FrizzyElectronics/OLEDModule/README.md

# OLEDModule
LED display with a SSD1306 I2C LCD. This module integrates perfectly with the I2C connector on our [Grape Board](https://github.com/FrizzyElectronics/Grape). The board is designed for 0.96" OLED screen as seen on [here](https://www.buydisplay.com/download/manual/ER-OLED0.96_Series_Datasheet.pdf)
