FrizzyElectronics/OLEDModule/images/Design/Outline.dxf

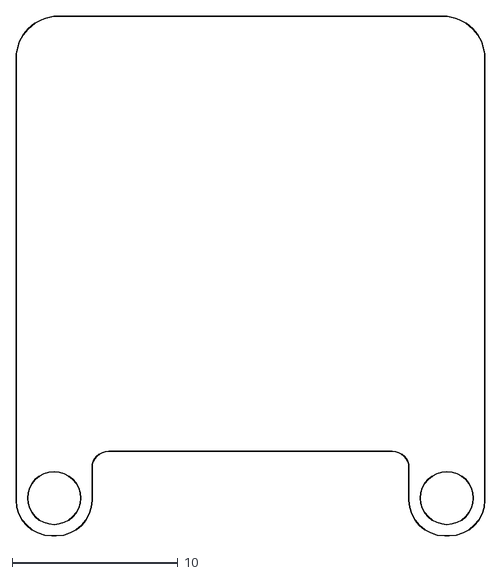
[picture p1: CAD file, 2017-05-22]
images/Design/Outline.dxf
28.3 x 31.4
