FrizzyElectronics/OLEDModule/pdf/OLEDModule.pdf

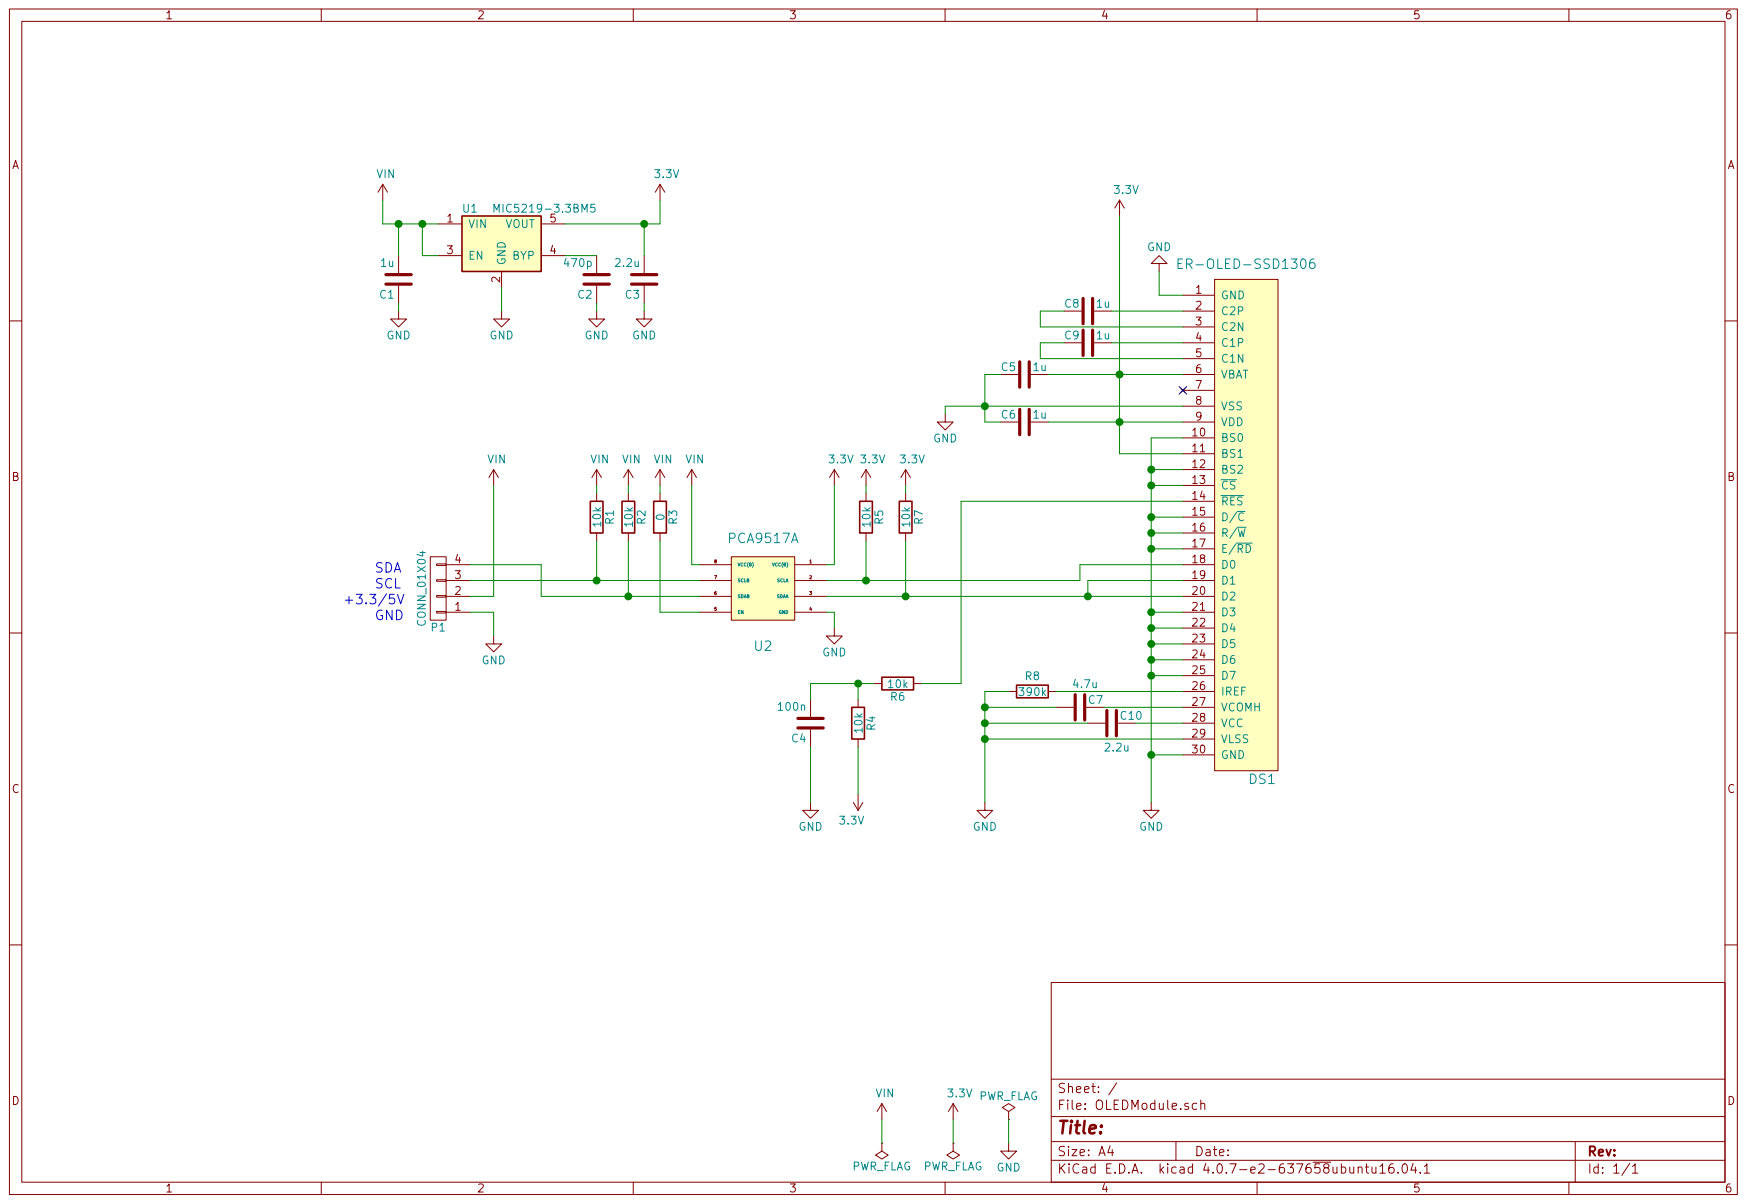
[picture p2: page 1]
