FrizzyElectronics/OLEDModule/(commit log)

2017-05-14 Esquema terminado
    [OLEDModule.kicad_pcb, OLEDModule.sch]
2017-05-15 empezando el layout
    [OLEDModule.kicad_pcb]
2017-05-15 Conector cambiado a SMD
    [OLEDModule.kicad_pcb, OLEDModule.sch]
2017-05-22 Placa enrutada
    [OLEDModule.kicad_pcb, _saved_OLEDModule.sch]
2017-05-22 Board outline
    [Outline.dxf]
2017-05-22 Placa enrutada y trabajando en el outline
    [OLEDModule.kicad_pcb, OLEDModule.sch, _saved_OLEDModule.sch]
2017-05-22 Working on the outline
    [Outline.dxf]
2017-05-22 Outline uploaded
    [Outline.dxf]
2017-05-22 Outline terminado
    [OLEDModule.kicad_pcb]
2017-05-22 Diseño terminado v1.0
    [OLEDModule.kicad_pcb]
2017-05-22 Diseño mandado a fabrica
    [OLEDModule.kicad_pcb]
2017-06-12 Pista haciendo corto arreglada
    [OLEDModule.kicad_pcb]
2018-01-20 Gerbers exportados
    Gerbers exportados para prueba de panelizacion
    [OLEDModule-B.Cu.gbl, OLEDModule-B.Mask.gbs, OLEDModule-B.SilkS.gbo, OLEDModule-Edge.Cuts.gko, OLEDModule-F.Cu.gtl, OLEDModule-F.Mask.gts, OLEDModule-F.SilkS.gto, OLEDModule.drl]
2018-02-05 logo nuevo cambiado
    [OLEDModule.kicad_pcb]
2018-03-04 arbol de carpetas cambiado
    [OLEDModule-B.Cu.gbl, OLEDModule-B.Mask.gbs, OLEDModule-B.SilkS.gbo, OLEDModule-Edge.Cuts.gko, OLEDModule-F.Cu.gtl, OLEDModule-F.Mask.gts, OLEDModule-F.SilkS.gto, OLEDModule.drl]
2018-05-06 BOM exportado
    [OLEDModule.csv]
2018-05-06 gerbers exportado
    [OLEDModule-B.Cu.gbl, OLEDModule-B.Mask.gbs, OLEDModule-B.SilkS.gbo, OLEDModule-Edge.Cuts.gko, OLEDModule-F.Cu.gtl, OLEDModule-F.Mask.gts, OLEDModule-F.SilkS.gto, OLEDModule.drl]
2018-07-14 Re-rellenado el plano de masa
    [OLEDModule.kicad_pcb]
2018-07-15 Gerbers exportados
    [OLEDModule.kicad_pcb]
2018-07-15 Gerbers actualizados
    [OLEDModule-B.Cu.gbl, OLEDModule-B.Mask.gbs, OLEDModule-B.SilkS.gbo, OLEDModule-Edge.Cuts.gm1, OLEDModule-F.Cu.gtl, OLEDModule-F.Mask.gts, OLEDModule-F.SilkS.gto, OLEDModule.drl]
